Aliasmk/EMRSNxEOS/README.md

# EMRSNxEOS

Project built in VSCode PlatformIO.

The system targets the ESP32, and uses the [OSC Library](https://github.com/CNMAT/OSC) and the [u8g2 graphics library](https://github.com/olikraus/u8g2).
