Aliasmk/EMRSNxEOS/PCB/V1/USB-B1HSB6--3DModel-STEP-56544.STEP

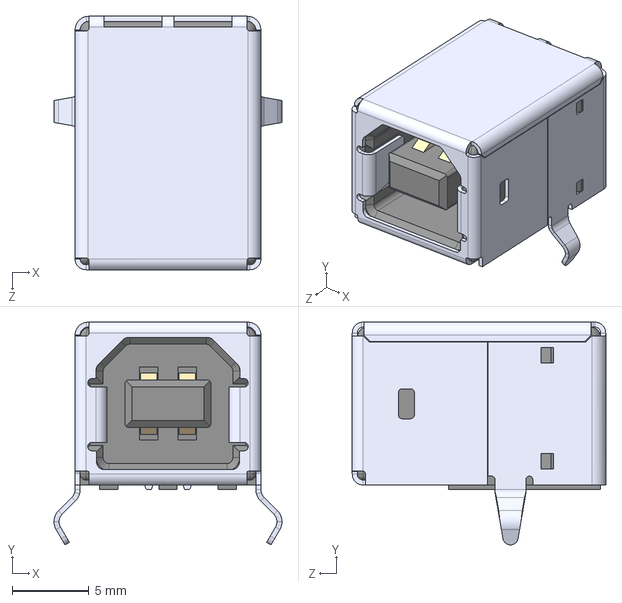
[picture p1: CAD file, 2021-01-13, an earlier design]
PCB/V1/USB-B1HSB6--3DModel-STEP-56544.STEP
14.8 x 14.5 x 16.5 mm
