Aliasmk/EMRSNxEOS/PCB/V1/PTS636SK25FSMTRLFS.stp

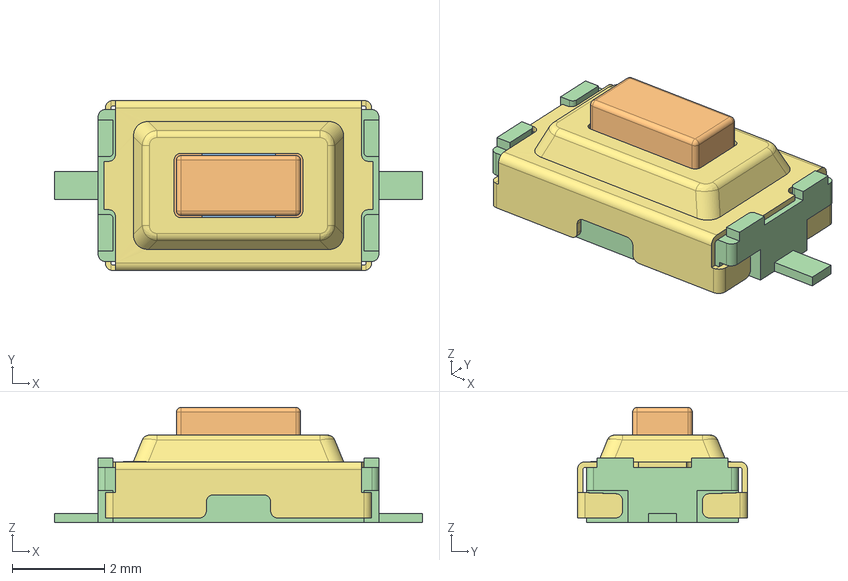
[picture p2: CAD file, 2021-01-13, an earlier design]
PCB/V1/PTS636SK25FSMTRLFS.stp
8.00 x 3.70 x 2.50 mm
MSBR-7_1_1
MSBR-6_1_1
MSBR-4_1_1
MSBR-3_2_1
MSBR-2_2_1
MSBR-1_2_1
PRT0001
