Aliasmk/EMRSNxEOS/PCB/V1/CUI_DEVICES_PJ-102AH.step

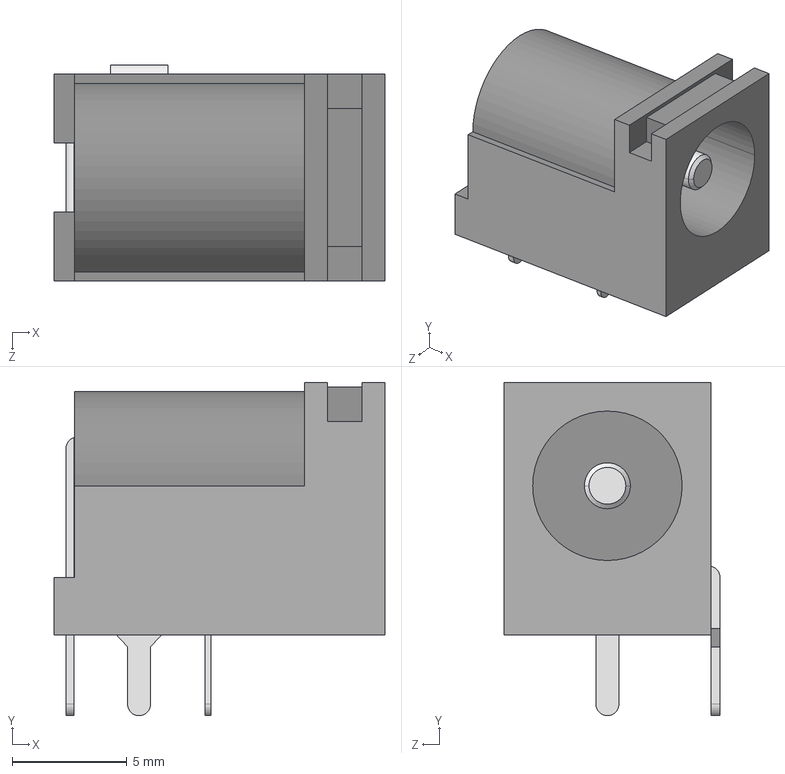
[picture p3: CAD file, 2021-01-13, an earlier design]
PCB/V1/CUI_DEVICES_PJ-102AH.step
14.4 x 14.5 x 9.40 mm
