Aliasmk/EMRSNxEOS/PCB/V1/676433910.stp

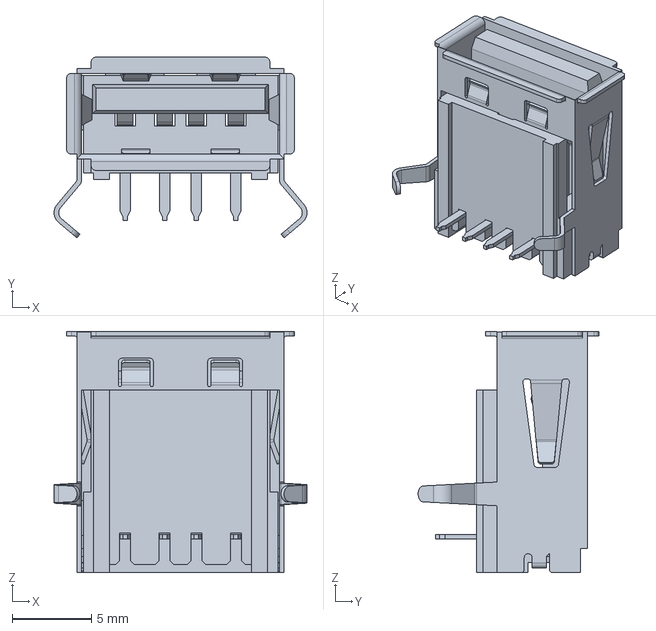
[picture p4: CAD file, 2021-01-13, an earlier design]
PCB/V1/676433910.stp
16.0 x 11.4 x 15.3 mm
