Aliasmk/EMRSNxEOS/PCB/V1/Console.pdf

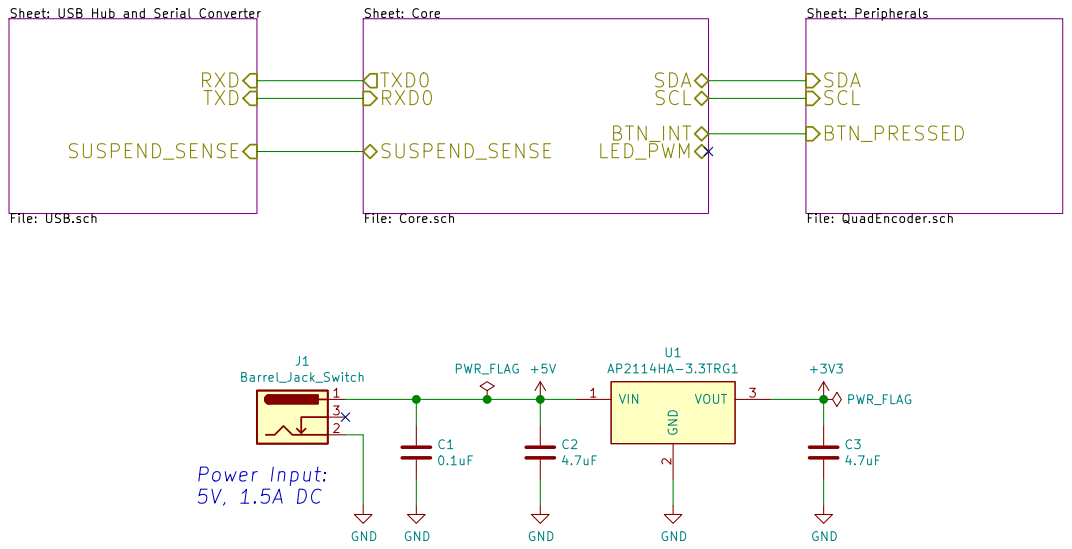
[picture p5: page 1]

Sheet: USB Hub and Serial Converter File: USB.schSUSPEND_SENSE

Sheet: Peripherals File: QuadEncoder.sch SDA

File: Console.sch Sheet: /
Id: 1/8 Title: EMRSNxEOS Console

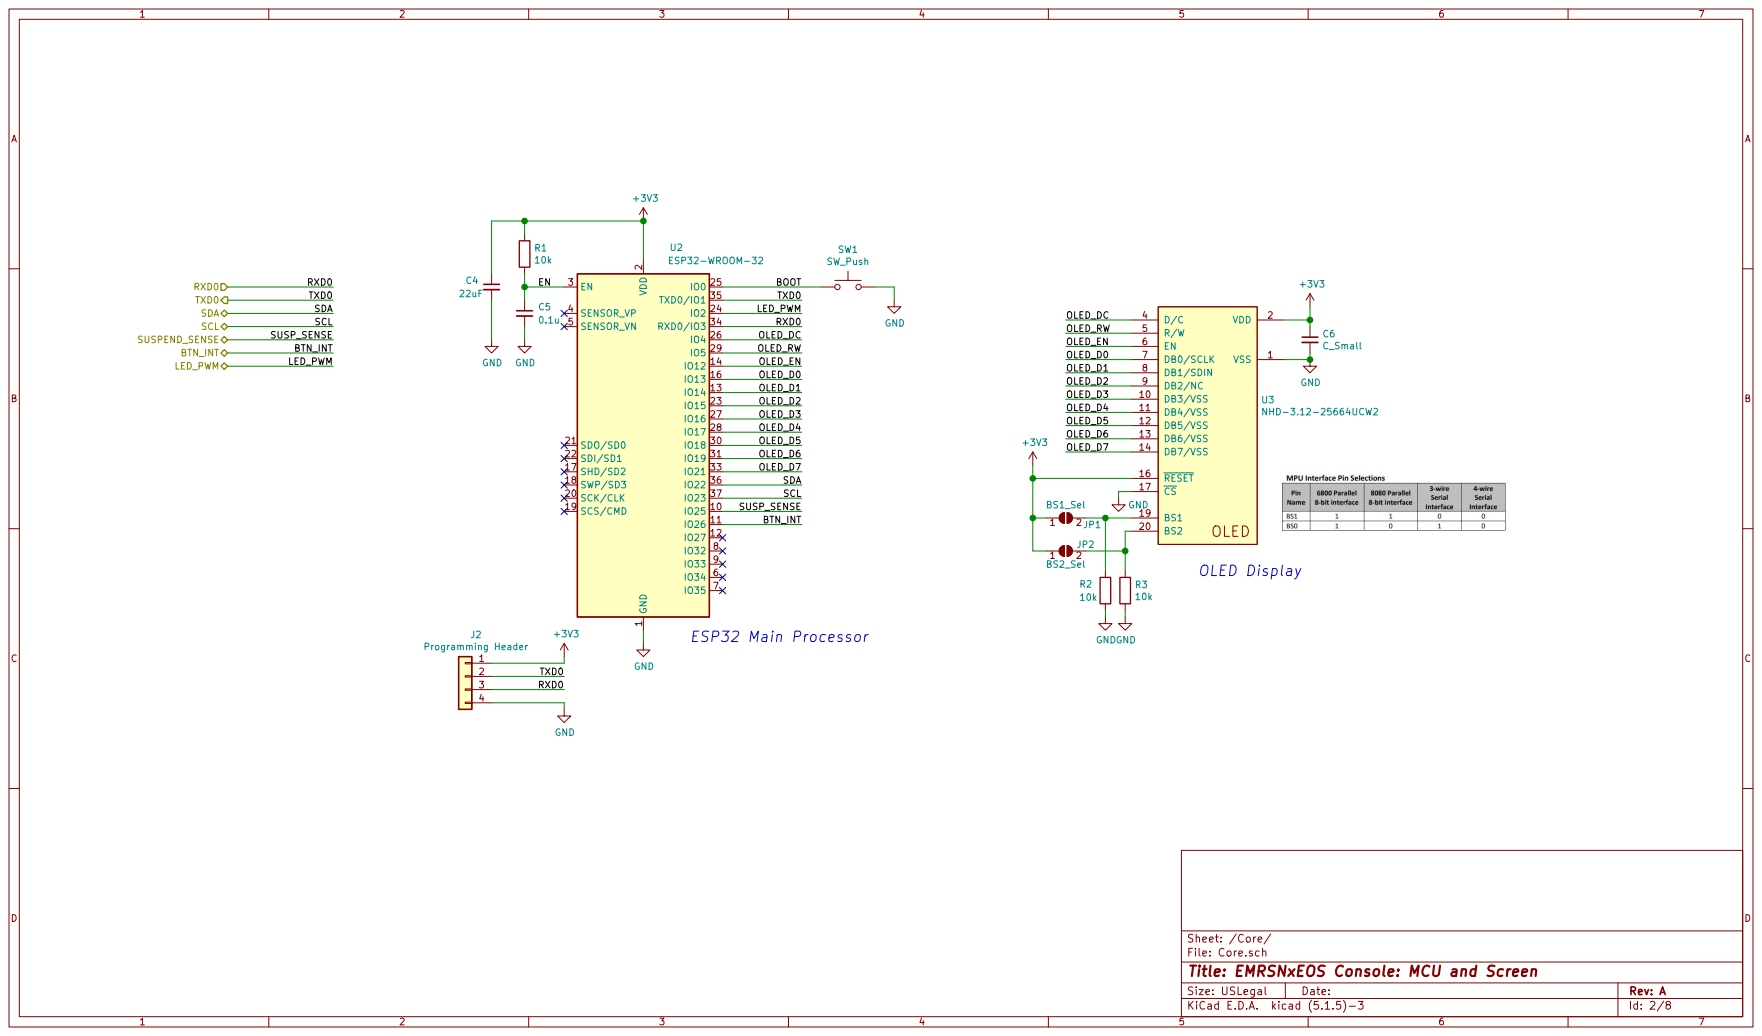
[picture p6: page 2]

2 SCK/CLK 20 SDO/SD0 21 SDI/SD1 22
+3V3C6C_Small GND

D Date: KiCad E.D.A. kicad (5.1.5)-3
File: Core.sch Sheet: /Core/
Id: 2/8 Title: EMRSNxEOS Console: MCU and Screen

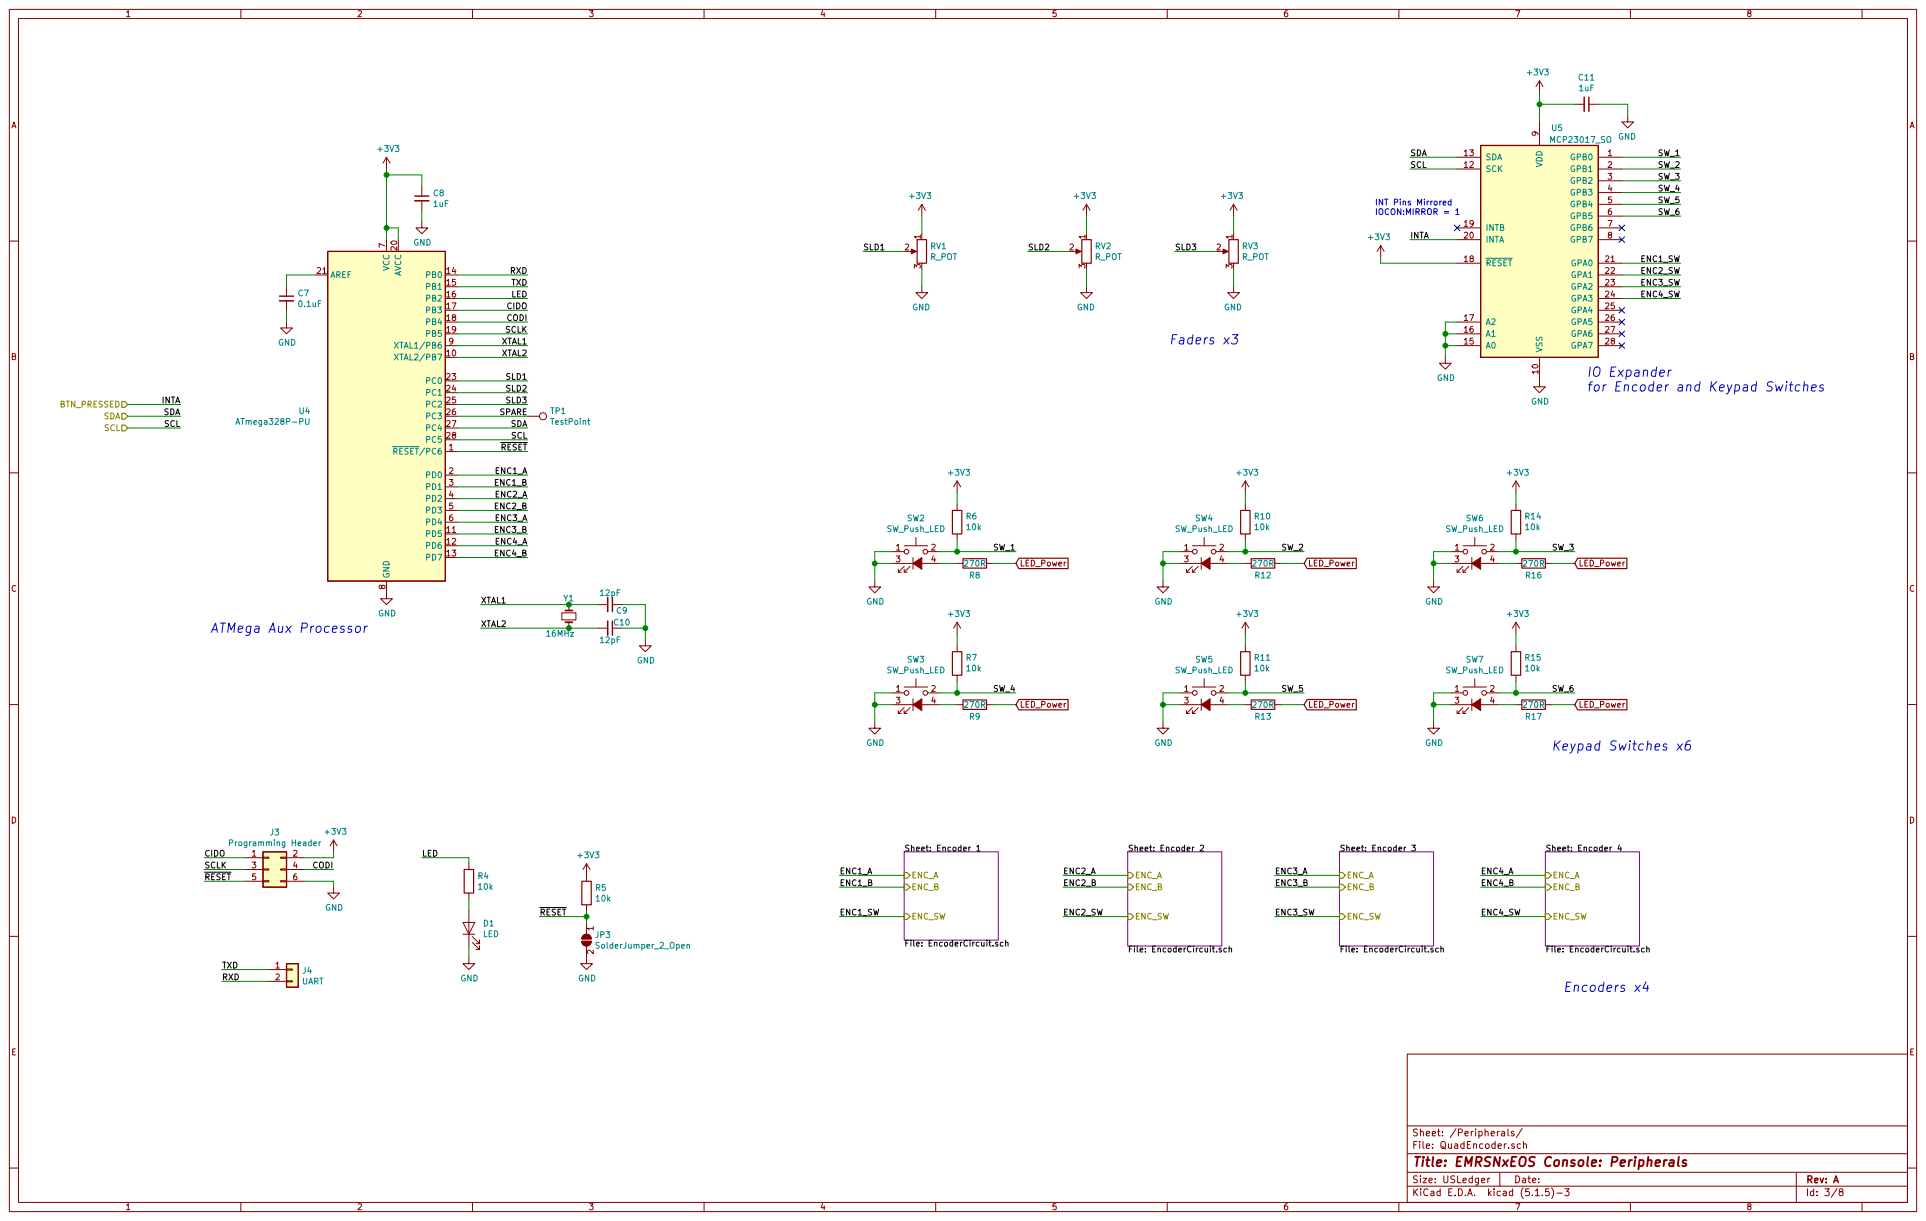
[picture p7: page 3]

IO Expander
for Encoder and Keypad Switches

Sheet: Encoder 1 File: EncoderCircuit.sch ENC_SW

Sheet: /Peripherals/ Sheet: Encoder 2 File: EncoderCircuit.sch ENC_SW

Sheet: Encoder 3 File: EncoderCircuit.sch ENC_SW

Sheet: Encoder 4 File: EncoderCircuit.sch ENC_SW

File: QuadEncoder.sch
Id: 3/8 Title: EMRSNxEOS Console: Peripherals

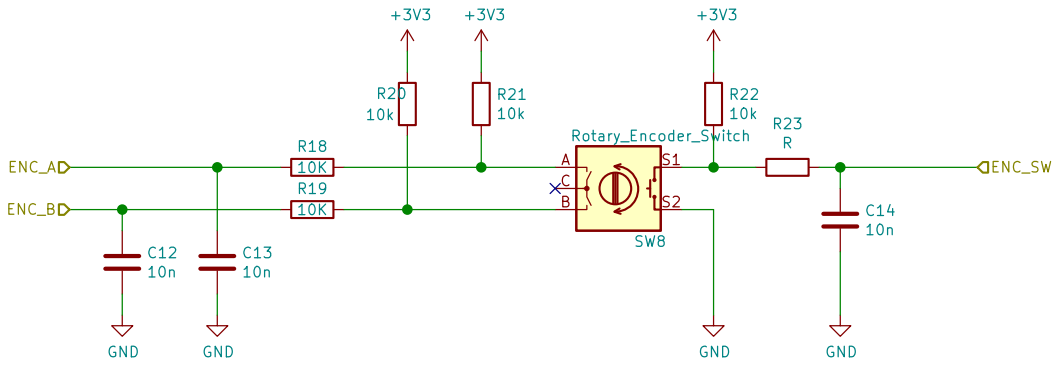
[picture p8: page 4]

File: EncoderCircuit.sch Sheet: /Peripherals/Encoder 2/
Id: 4/8 Title: EMRSNxEOS Console

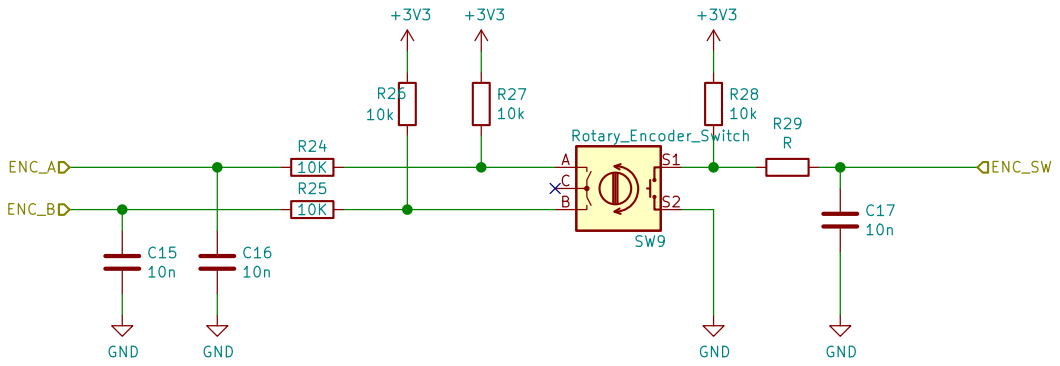
[picture p9: page 5]

File: EncoderCircuit.sch Sheet: /Peripherals/Encoder 3/
Id: 5/8 Title: EMRSNxEOS Console

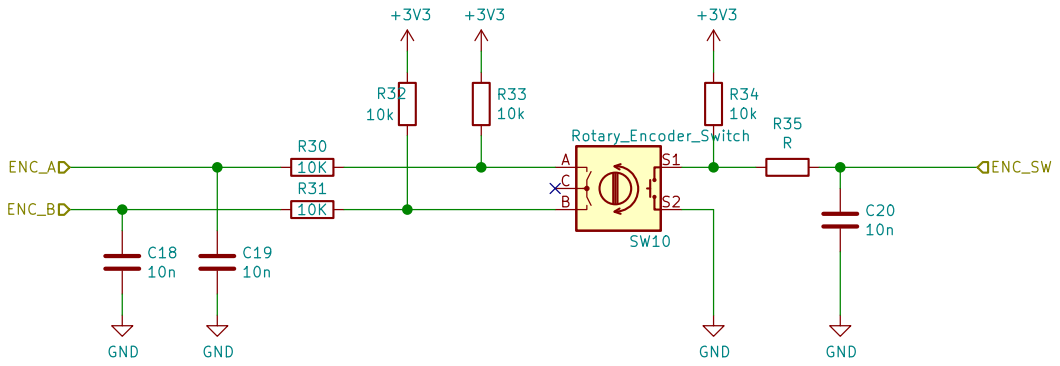
[picture p10: page 6]

File: EncoderCircuit.sch Sheet: /Peripherals/Encoder 4/
Id: 6/8 Title: EMRSNxEOS Console

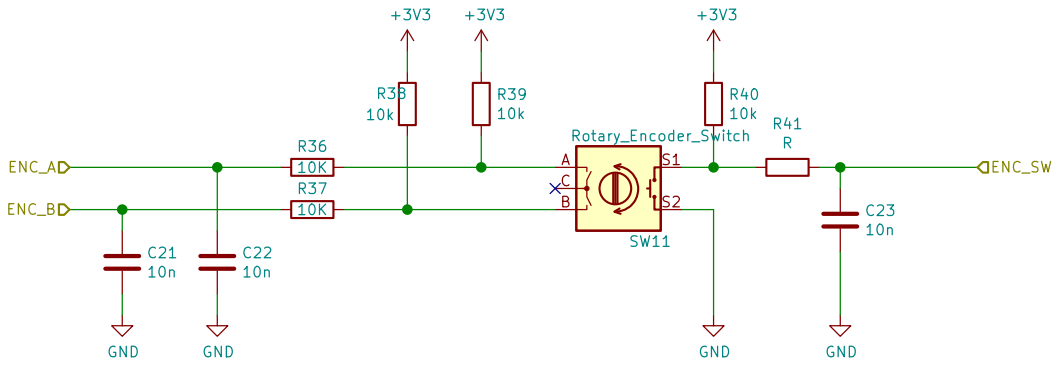
[picture p11: page 7]

File: EncoderCircuit.sch Sheet: /Peripherals/Encoder 1/
Id: 7/8 Title: EMRSNxEOS Console

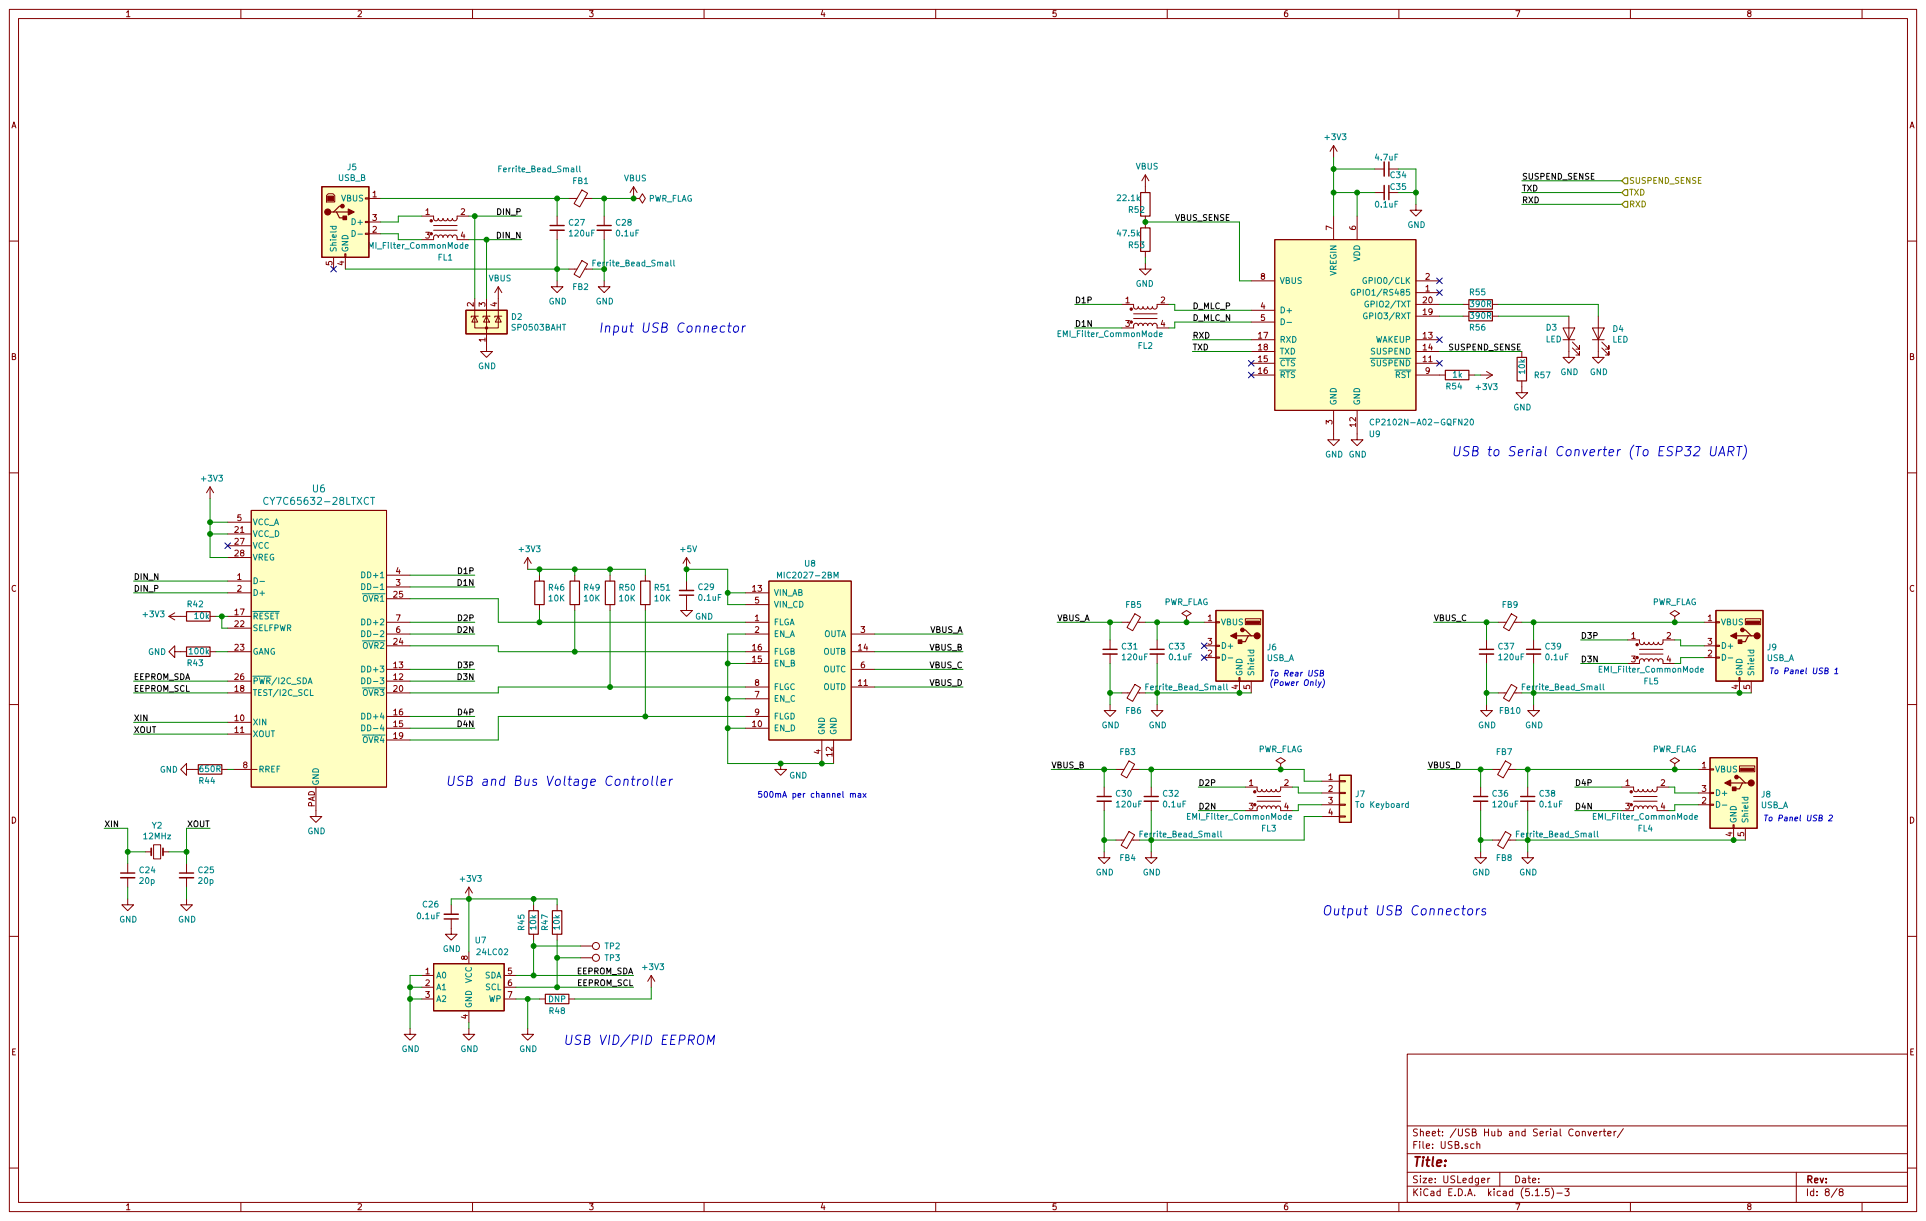
[picture p12: page 8]

7 VBUS 8 RST 9 U9CP2102N-A02-GQFN20 GND GND

4 VIN_CD 5 OUTC 6 EN_C 7 FLGC 8 FLGD 9 U8 MIC2027-2BM GND GND

USB and Bus Voltage Controller

Id: 8/8 Title: File: USB.sch Sheet: /USB Hub and Serial Converter/ GND

4 SDA 5 SCL 6 WP 7 VCC

USB VID/PID EEPROM
