Aliasmk/EMRSNxEOS/PCB/V3/Console.kicad_pcb

## KiCad design PCB/V3/Console.kicad_pcb (2021-05-02)

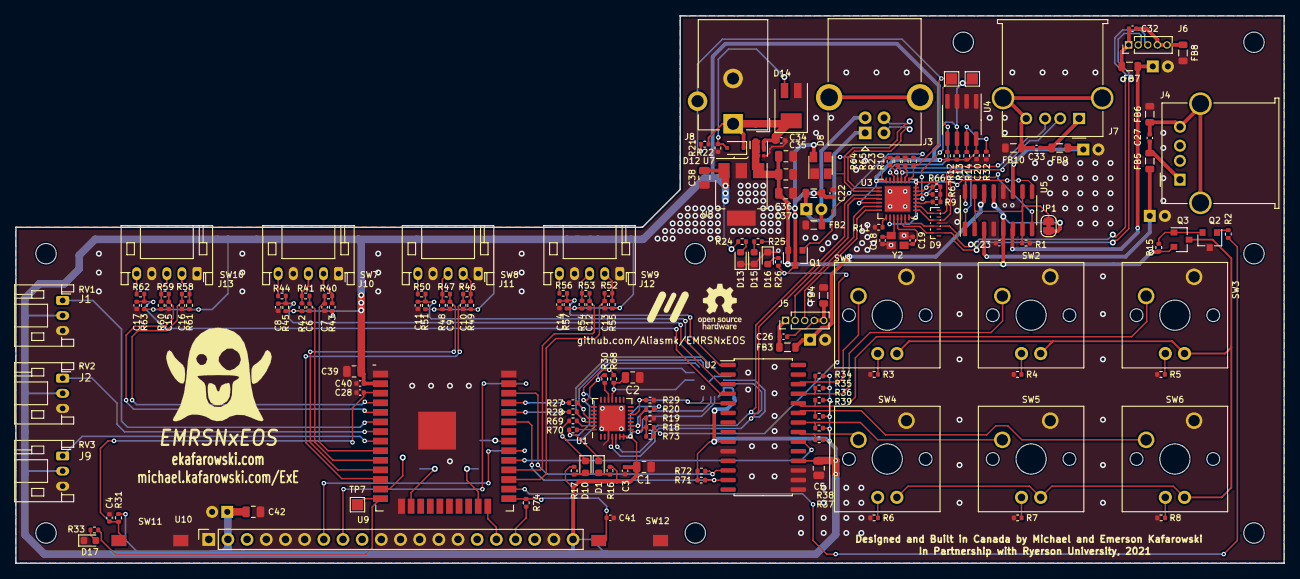
[picture p13: board Console.kicad_pcb from above]

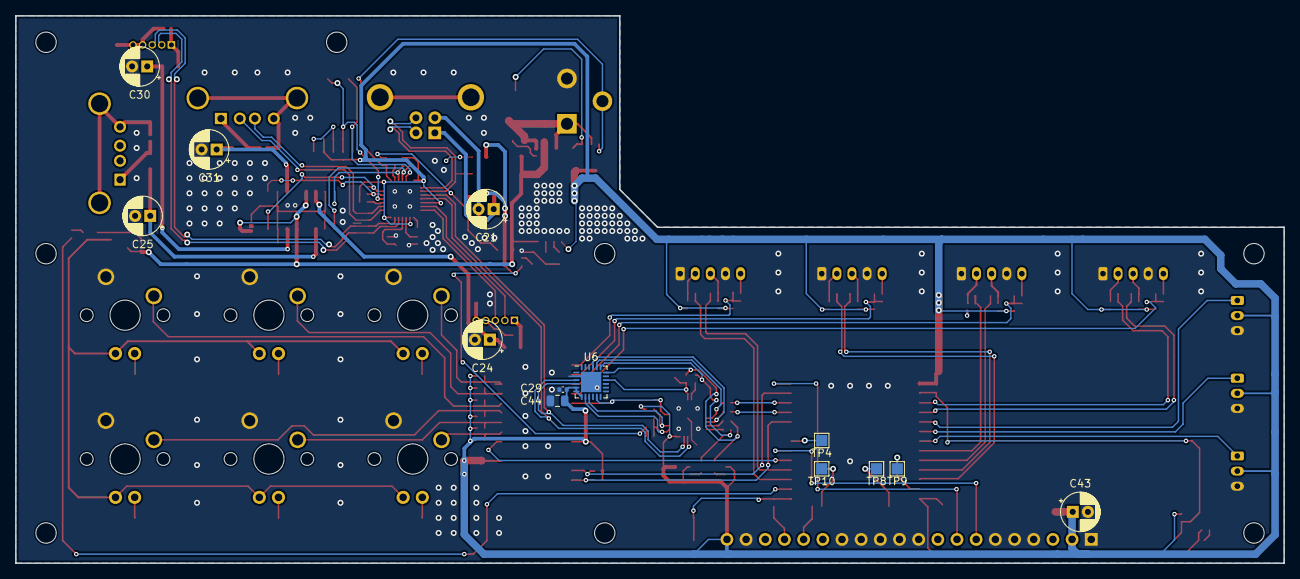
[picture p14: board Console.kicad_pcb from below]

Board: 2 copper layers, 168.0 x 72.5 mm, 198 parts (13 on the bottom side), 121 nets.

Parts:
C1, C2, C5, C29, C35, C36, C38, C42: 4.7uF; C_0805_2012Metric
C3, C4, C8, C11, C14, C17, C20, C22, C23, C26, C27, C28, C32, C33, C34, C40, C41, C44: 0.1uF; C_0402_1005Metric
C6, C7, C9, C10, C12, C13, C15, C16: 10n; C_0402_1005Metric
C18, C19: 20p; C_0402_1005Metric
C21, C24, C25, C30, C31, C43: 120uF; CP_Radial_D5.0mm_P2.00mm
C37, C39: 22uF; C_0805_2012Metric
D1, D10: LED_Orange; LED_0603_1608Metric
D8: SP0503BAHT; SOT-143
D9: DT1240A-08LP3810; UDFN-9_1.0x3.8mm_P0.5mm
D12: DDZ5V6BSF-7; D_SOD-323F
D13: LED_Red; LED_0603_1608Metric
D14: S4SRP; D_SMB_Modified
D15, D17: LED_Green; LED_0603_1608Metric
D16: LED_Blue; LED_0603_1608Metric
FB1, FB2, FB3, FB4, FB5, FB6, FB7, FB8, FB9, FB10: Ferrite_Bead_Small; L_0805_2012Metric
H1, H2, H3, H4, H5, H6, H7, H8: MountingHole; MountingHole_2.7mm_M2.5
H9: GhostLogo; Ghost
H10: OSHWLogo; OSHW-Logo_5.7x6mm_SilkScreen
J1, J2, J9: SliderConnector; JST_PH_S3B-PH-K_1x03_P2.00mm_Horizontal
J3: USB_B; USB_B_OST_USB-B1HSxx_Horizontal
J4, J7: USB_A; USB_A_Molex_67643_Horizontal
J5, J6: USB_A; PinHeader_1x05_P1.27mm_Vertical
J8: Barrel_Jack_Switch; BarrelJack_CUI_PJ-102AH_Horizontal
J10, J11, J12, J13: EncoderConnector; JST_PH_S5B-PH-K_1x05_P2.00mm_Horizontal
JP1: ActiveHigh; SolderJumper-2_P1.3mm_Bridged_RoundedPad1.0x1.5mm
Q1, Q3: CPH3356-TL-W; SOT-23
Q2: MMBT3904; SOT-23
R1, R9, R12, R13, R20, R29, R31, R32, R34, R35, R36, R37, R38, R39, R40, R41, R42, R43, R45, R46, R47, R48, R49, R51, R52, R53, R54, R55, R57, R58, R59, R60, R61, R63, R64, R65, R66, R67: 10k; R_0402_1005Metric
R2, R10, R15: 100k; R_0402_1005Metric
R3, R4, R5, R6, R7, R8, R16, R17, R24, R25, R26, R33: 270R; R_0402_1005Metric
R11: 650R; R_0402_1005Metric
R14, R30, R68: DNP; R_0402_1005Metric
R18, R19, R73: 47.5k; R_0402_1005Metric
R21: 510k; R_0402_1005Metric
R22, R44, R50, R56, R62: 1k; R_0402_1005Metric
R23, R71, R72: 4.7k; R_0402_1005Metric
R27, R28, R69, R70, R74: 0R; R_0402_1005Metric
RV1, RV2, RV3: R_POT; BOM_ONLY
SW1, SW2, SW3, SW4, SW5, SW6: SW_Push_LED; SW_Cherry_MX_Single_LED
SW7, SW8, SW9, SW10: Rotary_Encoder_Switch; BOM_ONLY
SW11, SW12: SW_Push; PTS636 SK25F SMTR LFS
TP2, TP3, TP4, TP7, TP8, TP9, TP10: TestPoint; TestPoint_Pad_1.5x1.5mm
U1: CP2102N-A01-GQFN28; QFN-28-1EP_5x5mm_P0.5mm_EP3.35x3.35mm
U2: MCP23017_SO; SOIC-28W_7.5x17.9mm_P1.27mm
U3: CY7C65632-28LTXC; QFN-28-1EP_5x5mm_P0.5mm_EP3.35x3.35mm
U4: 24LC02; SOIC-8_3.9x4.9mm_P1.27mm
U5: MIC2027; SOIC-16_3.9x9.9mm_P1.27mm
U6: CP2110-24QFN; QFN-24-1EP_4x4mm_P0.5mm_EP2.7x2.7mm
U7: DMP1005UFDF; Diodes_UDFN2020-6_Type-F
U8: AP2114HA-3.3TRG1; SOT-223-3_TabPin2
U9: ESP32-WROOM-32
U10: 1-535541-8 (Connector); PinSocket_1x20_P2.54mm_Vertical
Y2: 12MHz; ECS-120-12-36-AGN

Connections:
+3V3: C1.2, C3.2, C5.2, C20.2, C29.2, C38.1, C39.1, C40.2, C42.2, C43.1, C44.2, J1.2, J2.2, J9.2, R9.1, R12.2, R13.2, R14.1, R16.1, R17.1, R20.2, R24.2, R31.1, R34.1, R35.1, R36.1, R37.1, R38.1, R39.1, R42.2, R43.2, R45.1, R48.2, R49.2, R51.1, R54.2, R55.2, R57.1, R60.2, R61.2, R63.1, R64.1, R65.1, R66.1, R67.1, R71.2, R72.2, U1.6, U1.7, U2.9, U2.18, U3.5, U3.9, U3.14, U3.21, U3.28, U4.8, U6.5, U6.6, U6.7, U8.3, U9.2, U10.2, U10.20
+5V: C23.2, C35.1, C36.1, C37.1, JP1.1, Q1.2, Q3.2, R15.2, R25.2, U5.5, U5.13, U7.1, U7.2, U7.5, U7.6, U7.7, U8.1
/Core/BOOT: C41.2, R74.2, SW12.1, U9.25
/Core/BTN_INT: U2.20, U9.29
/Core/EN: C4.2, C28.2, R31.2, SW11.1, U9.3
/Core/ENC1_A: C16.1, R58.2, U9.4
/Core/ENC1_B: C15.1, R59.2, U9.5
/Core/ENC2_A: C7.1, R40.2, U9.9
/Core/ENC2_B: C6.1, R41.2, U9.10
/Core/ENC3_A: C10.1, R46.2, U9.12
/Core/ENC3_B: C9.1, R47.2, U9.11
/Core/ENC4_A: C13.1, R52.2, U9.27
/Core/ENC4_B: C12.1, R53.2, U9.28
/Core/ESP_RXD: R28.1, U9.34
/Core/ESP_TXD: R27.1, U9.35
/Core/LED: R33.1, TP7.1, U9.14
/Core/LED_PWM: R2.1, U9.26
/Core/OLED_~CS: R74.1, U10.17
/Core/OLED_~RESET: U9.24, U10.16
/Core/RSTb: R20.1, U1.9, U6.9
/Core/RXD0: R27.2, U1.25, U6.20
/Core/RXT: D10.1, R68.1, R69.1, U6.18
/Core/SCL: R72.1, U2.12, U9.36
/Core/SDA: R71.1, U2.13, U9.33
/Core/SLD1: J1.1, U9.6
/Core/SLD2: J2.1, U9.7
/Core/SLD3: J9.1, U9.8
/Core/SPARE1: TP8.1, U9.16
/Core/SPARE2: TP9.1, U9.13
/Core/SPARE3: TP10.1, U9.23
/Core/SPARE4: TP4.1, U9.31
/Core/SUS_SENSE: R29.1, U1.12, U2.5, U6.11
/Core/TXD0: R28.2, U1.26, U6.21
/Core/TXT: D1.1, R30.1, R70.1, U6.19
/Core/VBUS_SENSE: R18.1, R19.2, R73.1, U1.8, U6.8
/Core/VPP: C2.2, R68.2, U1.18, U6.16
/Core/VSPI_MOSI: U9.37, U10.8
/Core/VSPI_SCLK: U9.30, U10.7
/Peripherals/ENC1_SW: C17.1, R62.2, R63.2, U2.4
/Peripherals/ENC2_SW: C8.1, R44.2, R45.2, U2.3
/Peripherals/ENC3_SW: C11.1, R50.2, R51.2, U2.2
/Peripherals/ENC4_SW: C14.1, R56.2, R57.2, U2.1
/Peripherals/Encoder 1/A: J13.2, R58.1, R61.1
/Peripherals/Encoder 1/B: J13.3, R59.1, R60.1
/Peripherals/Encoder 1/S1: J13.5, R62.1
/Peripherals/Encoder 2/A: J10.2, R40.1, R43.1
/Peripherals/Encoder 2/B: J10.3, R41.1, R42.1
/Peripherals/Encoder 2/S1: J10.5, R44.1
/Peripherals/Encoder 3/A: J11.2, R46.1, R49.1
/Peripherals/Encoder 3/B: J11.3, R47.1, R48.1
/Peripherals/Encoder 3/S1: J11.5, R50.1
/Peripherals/Encoder 4/A: J12.2, R52.1, R55.1
/Peripherals/Encoder 4/B: J12.3, R53.1, R54.1
/Peripherals/Encoder 4/S1: J12.5, R56.1
/Peripherals/SW_1: R34.2, SW1.2, U2.26
/Peripherals/SW_2: R35.2, SW2.2, U2.25
/Peripherals/SW_3: R36.2, SW3.2, U2.24
/Peripherals/SW_4: R37.2, SW4.2, U2.21
/Peripherals/SW_5: R38.2, SW5.2, U2.22
/Peripherals/SW_6: R39.2, SW6.2, U2.23
/Power/SELF_POWER: J8.3, R21.2, R23.1, U3.22
/Power/VCC_IN: C34.1, D12.1, D14.2, J8.1, R21.1, U7.4, U7.8
/USB Hub and Serial Converter/D2N: J5.2, U3.6
/USB Hub and Serial Converter/D2P: J5.3, U3.7
/USB Hub and Serial Converter/D3N: D9.9, J6.2, U3.12
/USB Hub and Serial Converter/D3P: D9.8, J6.3, U3.13
/USB Hub and Serial Converter/D4N: D9.7, J7.2, U3.15
/USB Hub and Serial Converter/D4P: D9.6, J7.3, U3.16
/USB Hub and Serial Converter/DIN_N: D8.3, J3.2, U3.1
/USB Hub and Serial Converter/DIN_P: D8.2, J3.3, U3.2
/USB Hub and Serial Converter/EEPROM_SCL: R13.1, TP3.1, U3.18, U4.6
/USB Hub and Serial Converter/EEPROM_SDA: R12.1, TP2.1, U3.26, U4.5
/USB Hub and Serial Converter/USB_INT_N: U1.5, U3.3, U6.4
/USB Hub and Serial Converter/USB_INT_P: U1.4, U3.4, U6.3
/USB Hub and Serial Converter/VBUS_A: C25.1, FB5.2, U5.3
/USB Hub and Serial Converter/VBUS_B: C24.1, FB3.2, U5.14
/USB Hub and Serial Converter/VBUS_C: C30.1, FB7.2, U5.6
/USB Hub and Serial Converter/VBUS_D: C31.1, FB9.2, U5.11
/USB Hub and Serial Converter/XIN: C18.1, U3.10, Y2.1
/USB Hub and Serial Converter/XOUT: C19.1, U3.11, Y2.3
/USB Hub and Serial Converter/~OVR1: R64.2, U3.25, U5.1
/USB Hub and Serial Converter/~OVR2: R65.2, U3.24, U5.16
/USB Hub and Serial Converter/~OVR3: R66.2, U3.20, U5.8
/USB Hub and Serial Converter/~OVR4: R67.2, U3.19, U5.9
GND: C1.1, C2.1, C3.1, C4.1, C5.1, C6.2, C7.2, C8.2, C9.2, C10.2, C11.2, C12.2, C13.2, C14.2, C15.2, C16.2, C17.2, C18.2, C19.2, C20.1, C22.2, C23.1, C24.2, C25.2, C28.1, C29.1, C30.2, C31.2, C34.2, C35.2, C36.2, C37.2, C38.2, C39.2, C40.1, C41.1, C42.1, C43.2, C44.1, D8.1, D9.3, D13.1, D14.1, D15.1, D16.1, D17.1, FB2.1, FB4.2, FB6.2, FB8.2, FB10.2, J1.3, J2.3, J8.2, J9.3, J10.1, J10.4, J11.1, J11.4, J12.1, J12.4, J13.1, J13.4, Q2.3, R1.1, R3.2, R4.2, R5.2, R6.2, R7.2, R8.2, R10.1, R11.1, R19.1, R22.2, R29.2, R32.1, SW1.1, SW2.1, SW3.1, SW4.1, SW5.1, SW6.1, SW11.2, SW12.2, U1.3, U1.29, U2.10, U2.15, U2.16, U2.17, U3.29, U4.1, U4.2, U4.3, U4.4, U5.4, U5.12, U6.2, U6.25, U7.3, U8.2, U9.1, U9.15, U9.38, U9.39, U10.1, U10.4, U10.5, U10.6, U10.10, U10.11, U10.12, U10.13, U10.14, U10.19, Y2.2
LED_Power: Q3.3, SW1.4, SW2.4, SW3.4, SW4.4, SW5.4, SW6.4
unnamed: C21.1, FB1.2, J3.1
unnamed: C21.2, FB2.2, J3.4
unnamed: C26.1, FB3.1, J5.1
unnamed: C26.2, FB4.1, J5.4, J5.5
unnamed: C27.1, FB5.1, J4.1
unnamed: C27.2, FB6.1, J4.4, J4.5
unnamed: C32.1, FB7.1, J6.1
unnamed: C32.2, FB8.1, J6.4, J6.5
unnamed: C33.1, FB9.1, J7.1
unnamed: C33.2, FB10.1, J7.4, J7.5
unnamed: D1.2, R16.2
unnamed: D10.2, R17.2
unnamed: D12.2, D14.3, R22.1
unnamed: D13.2, R24.1
unnamed: D15.2, R25.1
unnamed: D16.2, R26.1
unnamed: D17.2, R33.2
unnamed: JP1.2, R1.2, U5.2, U5.7, U5.10, U5.15
unnamed: Q1.1, R23.2
unnamed: Q2.1, R2.2
unnamed: Q2.2, Q3.1, R15.1
unnamed: R3.1, SW1.3
unnamed: R4.1, SW2.3
unnamed: R5.1, SW3.3
unnamed: R6.1, SW4.3
unnamed: R7.1, SW5.3
unnamed: R8.1, SW6.3
unnamed: R9.2, U3.17
unnamed: R10.2, U3.23
unnamed: R11.2, U3.8
unnamed: R14.2, R32.2, U4.7
unnamed: R30.2, U1.19
unnamed: R69.2, U1.27
unnamed: R70.2, U1.28
VBUS: C22.1, D8.4, FB1.1, Q1.3, R18.2, R26.2, R73.2
