Aliasmk/EMRSNxEOS/Code/ConsoleCore/include/pins.hpp

#ifndef PINS_HPP
#define PINS_HPP

#define UNDEFINED_PIN 99

#define PIN_OLED_CS     15
#define PIN_ESP_TXD     1
#define PIN_OLED_RESET  2
#define PIN_ESP_RXD     3
#define PIN_LED_PWM     4
#define PIN_BTN_INT     5
#define PIN_LED         12
#define PIN_SPARE_1     13
#define PIN_SPARE_2     14
#define PIN_SPARE_3     15
#define PIN_ENC4_A      16
#define PIN_ENC4_B      17
#define PIN_VSPI_SCLK   18
#define PIN_SPARE_4     19
#define PIN_SDA         21
#define PIN_SCL         22
#define PIN_VSPI_MOSI   23
#define PIN_ENC2_B      25
#define PIN_ENC3_B      26
#define PIN_ENC3_A      27
#define PIN_SLD3        32
#define PIN_ENC2_A      33
#define PIN_SLD1        34
#define PIN_SLD2        35
#define PIN_ENC1_A      36
#define PIN_ENC1_B      39

#endif
