Aliasmk/EMRSNxEOS/(commit log)

2020-05-24 Fixed crash when using large number of params (serial buff overrun)
    [MainScreen.cpp, SettingsScreen.cpp, display.cpp, io.cpp, main.cpp, osc.cpp, osc.hpp]
2020-06-17 Integrated io/button class from HapticEye
2020-06-27 Prelim Encoder Code
2020-06-29 Add Wheel OSC commands
2020-07-02 Improved Encoder detection, coarse/fine, active parameter switch
2020-09-25 Code refactor; Electrical Schematic; Add ATMega WS
    [Console.kicad_pcb, Console.sch, Core.sch, Keypad.sch, Power.sch, QuadEncoder.sch, Sliders.sch]
2020-09-25 Schematic, Code Refactor, 328P workspace
    [Console.sch, Core.sch, EncoderCircuit.sch, Keypad.sch, Power.sch, QuadEncoder.sch, Sliders.sch, USB.sch]
2020-09-25 Refactor to change "IO" class to "Button"
2020-11-15 WIP PCB changes
    [Console (2).csv, Console.csv, Console.sch, Core.sch, EncoderCircuit.sch, Power.sch, QuadEncoder.sch, USB.sch]
2020-11-15 PCB "Complete", still needs checking etc
    [Console.kicad_pcb]
2021-01-13 PCB Version 1: As Sent to Fab
    [676433910.stp, CUI_DEVICES_PJ-102AH.step, Console (3).csv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]
2021-02-07 Fix display to work with new hardware. Implement io expander driver for using on board buttons
    [MainScreen.cpp, button.cpp, button.hpp, display.cpp, main.cpp, pins.hpp]
2021-03-21 WIP schematic work, ready to route board V2
    [676433910.stp, CUI_DEVICES_PJ-102AH.step, Console (2).csv, Console (3).csv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]
2021-03-26 PCB Sent
    [Console-B_Cu.gbr, Console-B_Mask.gbr, Console-B_Paste.gbr, Console-B_SilkS.gbr, Console-Edge_Cuts.gbr, Console-F_Cu.gbr, Console-F_Mask.gbr, Console-F_Paste.gbr]
2021-05-02 Code working with V2 board, V3 PCB created
    [Console.kicad_pcb, Console.sch, Core.sch, EncoderCircuit.sch, Power.sch, QuadEncoder.sch, USB.sch]
2021-05-03 Re-added encoder code, working well
2021-07-24 Keys now change page if clicked multiple times, Wi-Fi Ap enabled, fader type fix
    [MainScreen.cpp, console_wifi.cpp, fader.hpp, main.cpp]
