Aliasmk/EMRSNxEOS/(notices)

Notices in the files:
PCB/V1/PTS636SK25FSMTRLFS.stp:
FILE_NAME( 'p:/temp/worker_136/temp/exporttempdir_4592_609_SRRqz/format_0/PTS636SK25FSMTRLFS.stp', '2020-09-14T06:35:29', ( 'License CC BY-ND 4.0' ), ( 'CADENAS' ), ' ', 'PARTsolutions', ' ' );
